fraser125/drone-1.0/v1.0/DroneSchematic.pdf

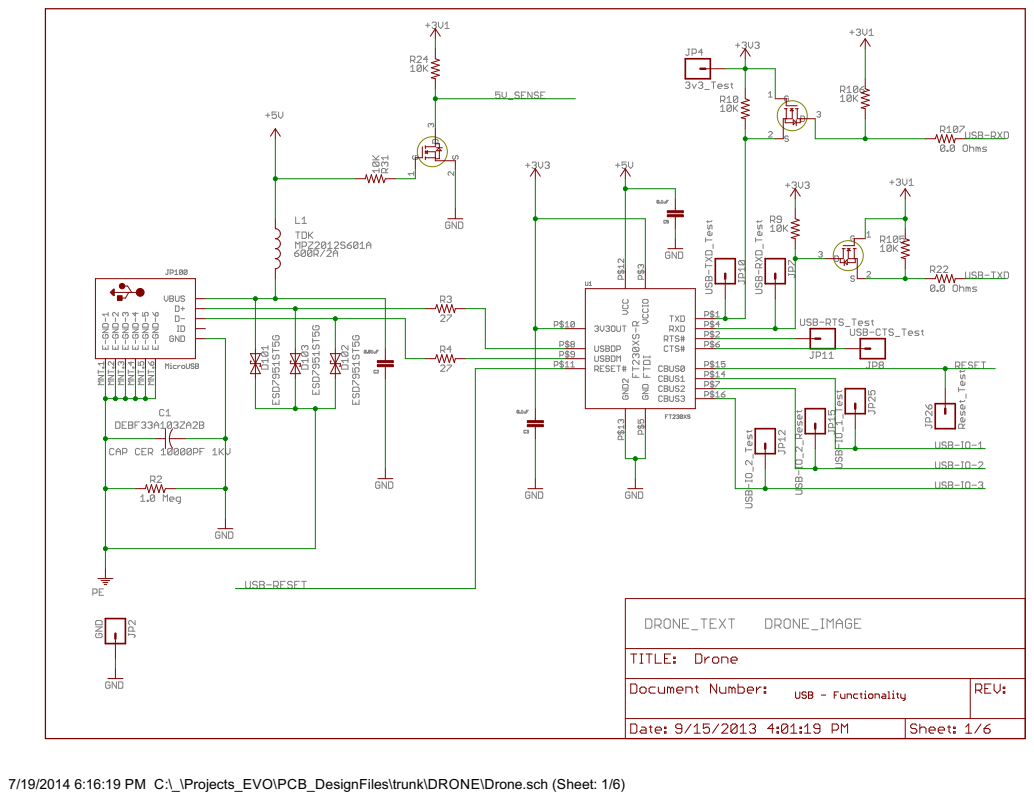
[picture p1: page 1]

7/19/2014 6:16:19 PM C:\_\Projects_EVO\PCB_DesignFiles\trunk\DRONE\Drone.sch (Sheet: 1/6)

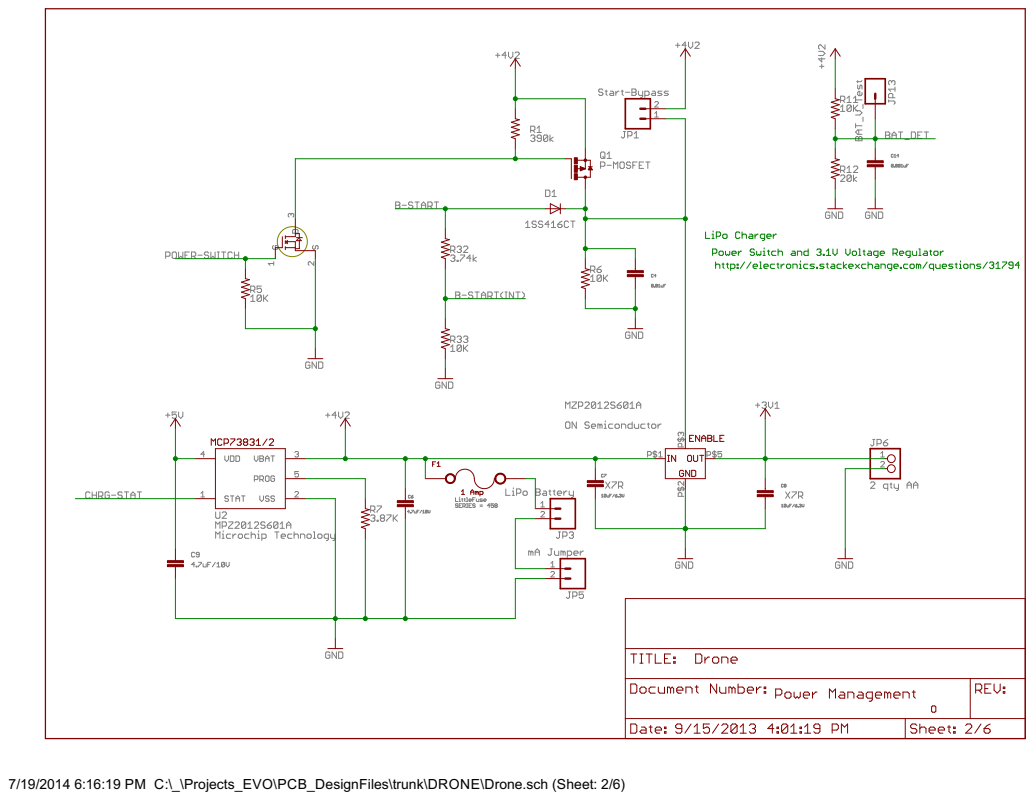
[picture p2: page 2]

7/19/2014 6:16:19 PM C:\_\Projects_EVO\PCB_DesignFiles\trunk\DRONE\Drone.sch (Sheet: 2/6)

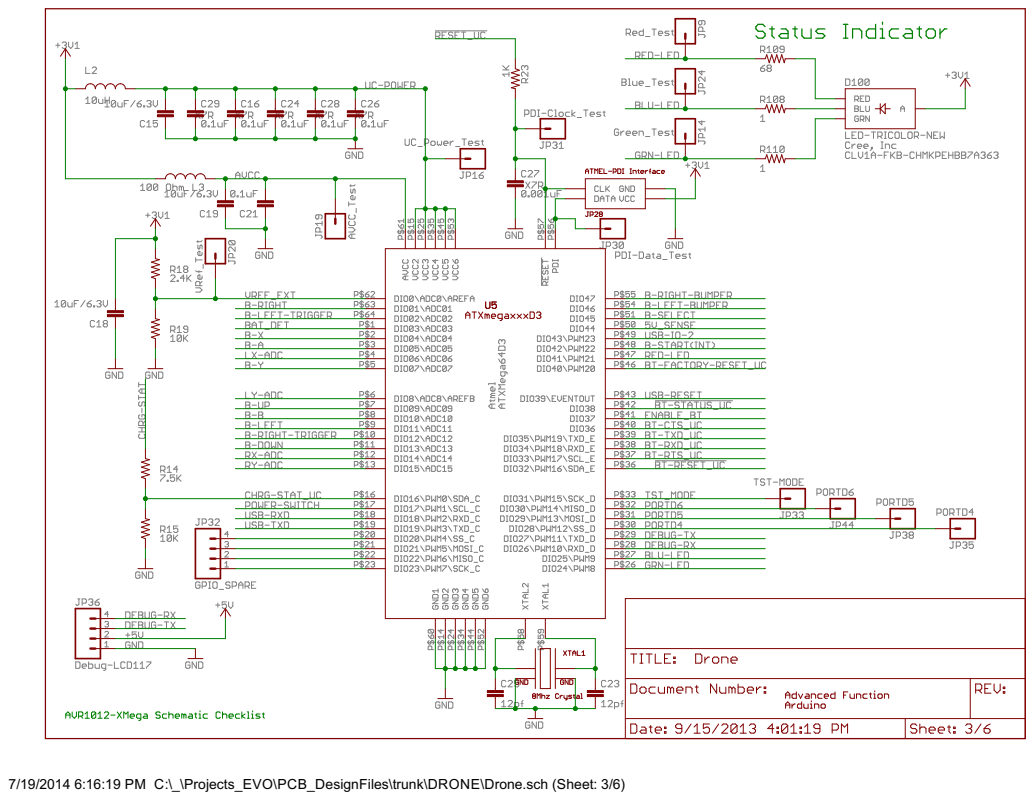
[picture p3: page 3]

7/19/2014 6:16:19 PM C:\_\Projects_EVO\PCB_DesignFiles\trunk\DRONE\Drone.sch (Sheet: 3/6)

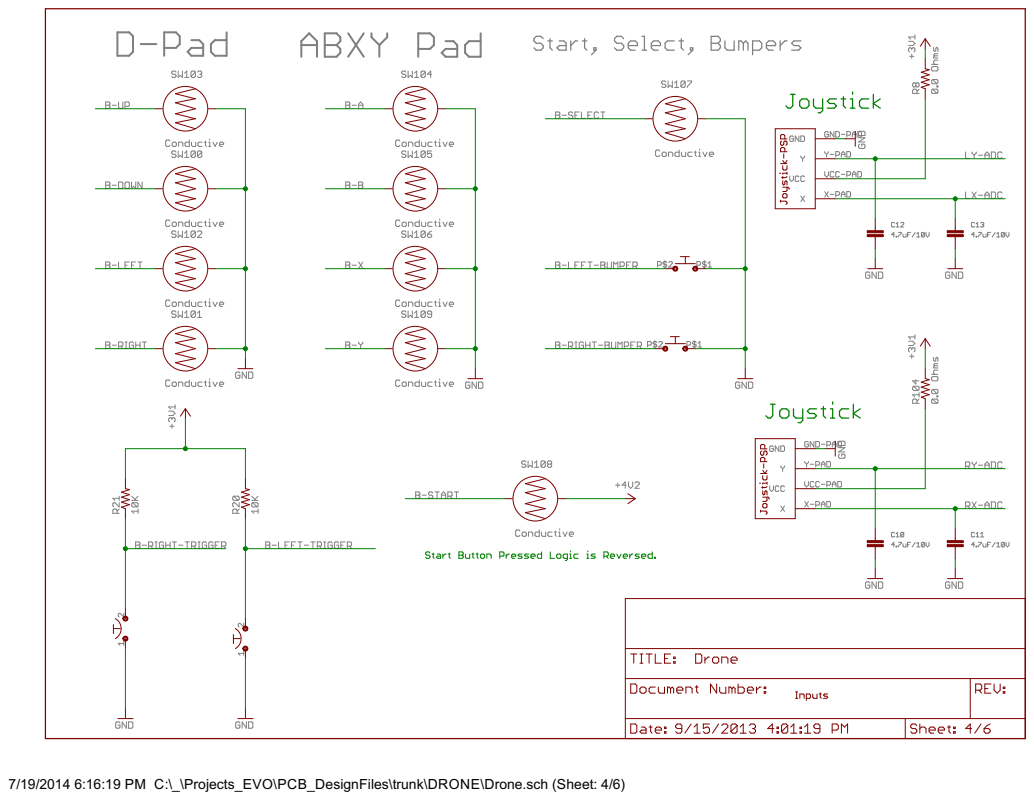
[picture p4: page 4]

7/19/2014 6:16:19 PM C:\_\Projects_EVO\PCB_DesignFiles\trunk\DRONE\Drone.sch (Sheet: 4/6)

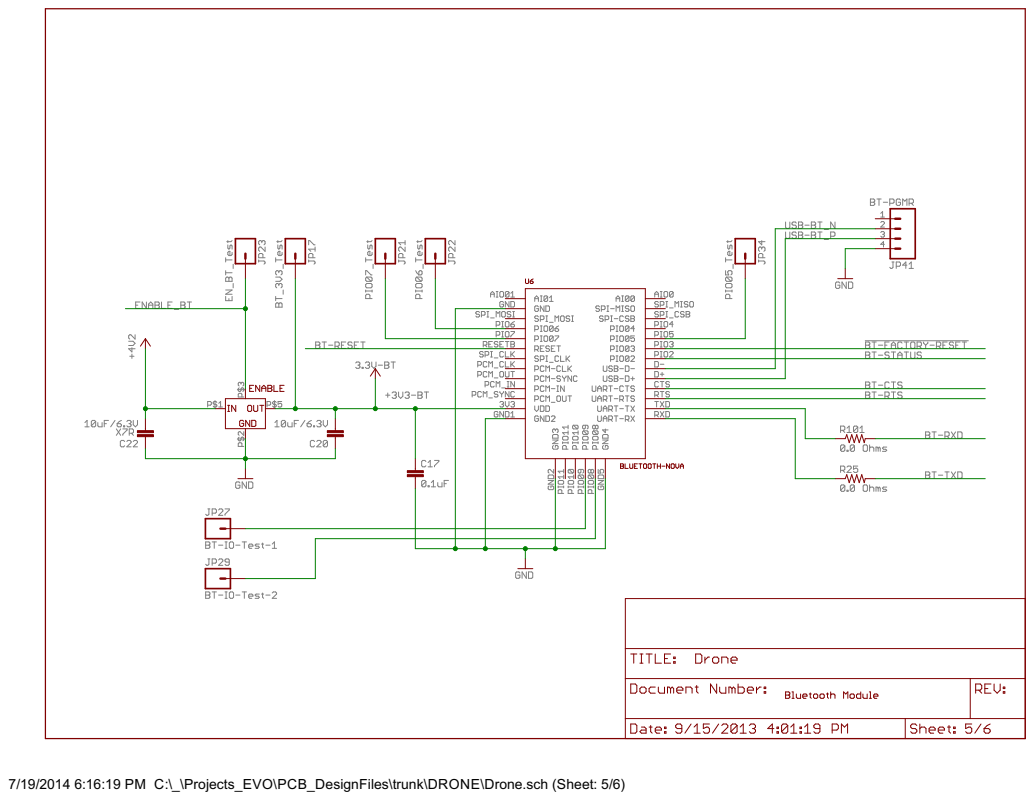
[picture p5: page 5]

7/19/2014 6:16:19 PM C:\_\Projects_EVO\PCB_DesignFiles\trunk\DRONE\Drone.sch (Sheet: 5/6)

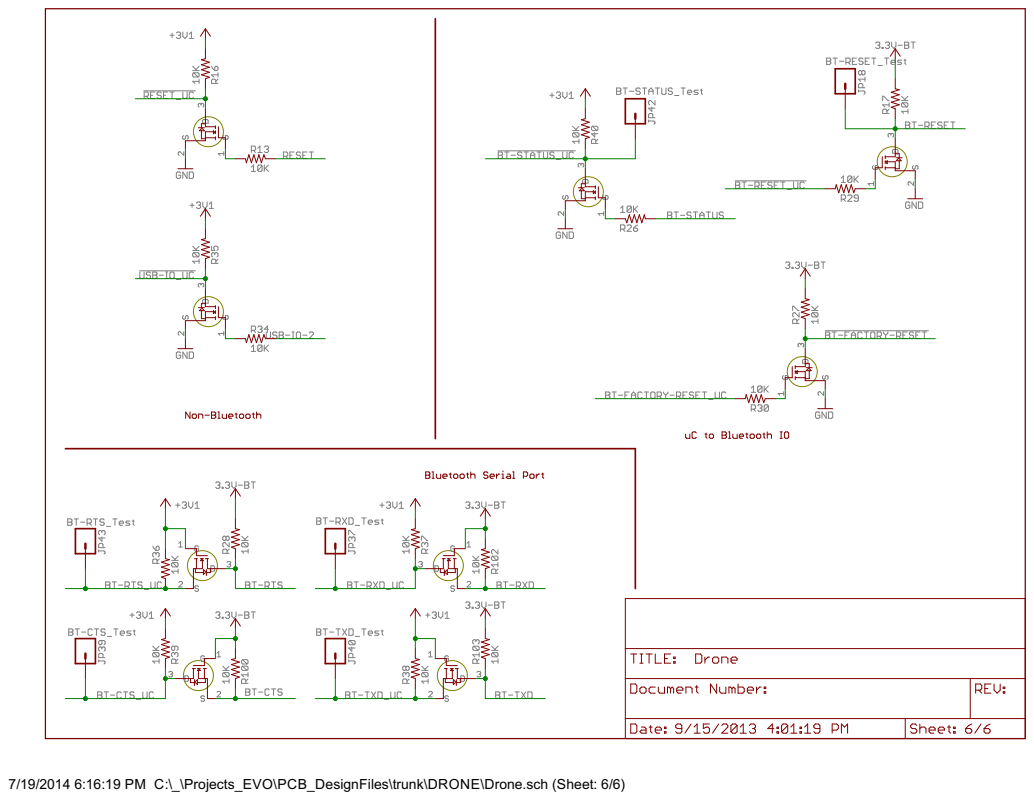
[picture p6: page 6]

7/19/2014 6:16:19 PM C:\_\Projects_EVO\PCB_DesignFiles\trunk\DRONE\Drone.sch (Sheet: 6/6)
