fraser125/drone-1.0/v2.1/droneupdate/droneupdate/stdafx.h

// stdafx.h : include file for standard system include files,
// or project specific include files that are used frequently, but
// are changed infrequently
//

#pragma once

#include "targetver.h"

#include <stdio.h>
#include <tchar.h>



// TODO: reference additional headers your program requires here
