fraser125/drone-1.0/(commit log)

2014-08-02 Bug fix
    Fixed lag issue on 4.0 devices.
    [config.h]
2014-08-02 Release 2.1
    Uploading new folder containing Drone 2.1 firmware. This has a few
    bluetooth firmware fixes and adds diagonal directional presses to the
    dpad.
    [battery.xlsx, configurations.h]
2019-02-18 Renamed Schematic PDF
